frederikkoopman/Micro-Movinghead-Stepper/wiki/images/BodyAssembled.jpg

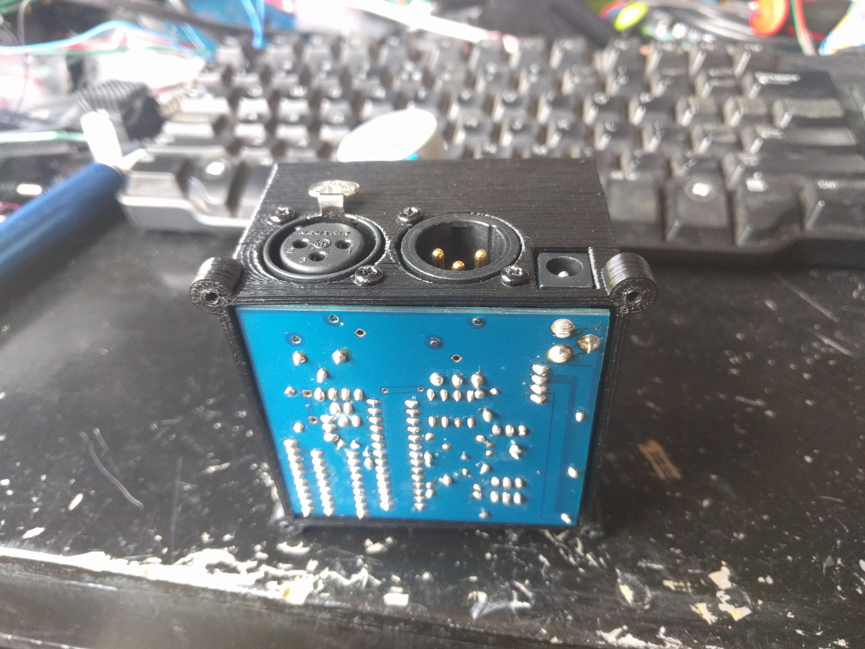
wiki/images/BodyAssembled.jpg
