frederikkoopman/Micro-Movinghead-Stepper/wiki/images/YokeMS.jpg

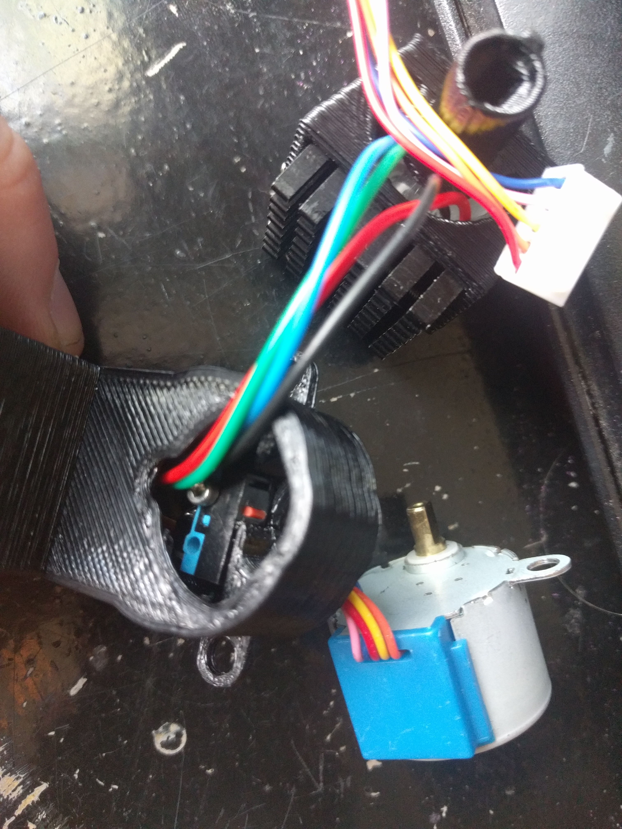
wiki/images/YokeMS.jpg
