frederikkoopman/Micro-Movinghead-Stepper/README.md

# Micro-Movinghead-Stepper
Micro Movinghead project stepper version
