frederikkoopman/Micro-Movinghead-Stepper/PCB/inputboard/readme.md

All Eagle files are here if your only interested in building not designing the zip file has all the files you need to order a PCB at your favorite PCB maker
