frederikkoopman/Micro-Movinghead-Stepper/wiki/images/Body.jpg

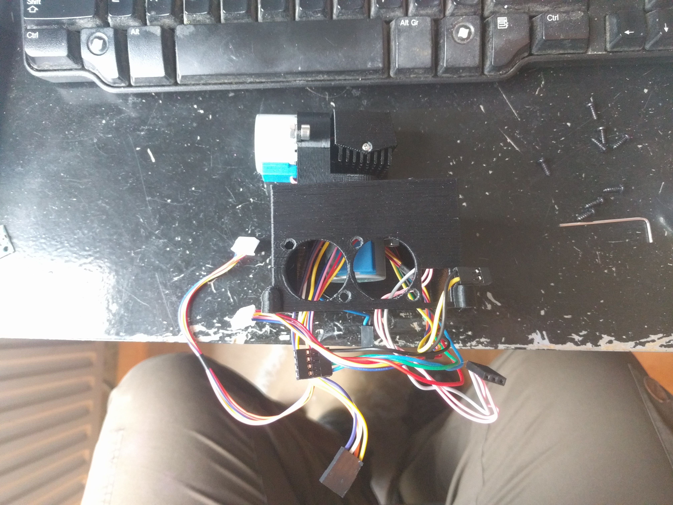
wiki/images/Body.jpg
