frederikkoopman/Micro-Movinghead-Stepper/wiki/images/Connections.jpg

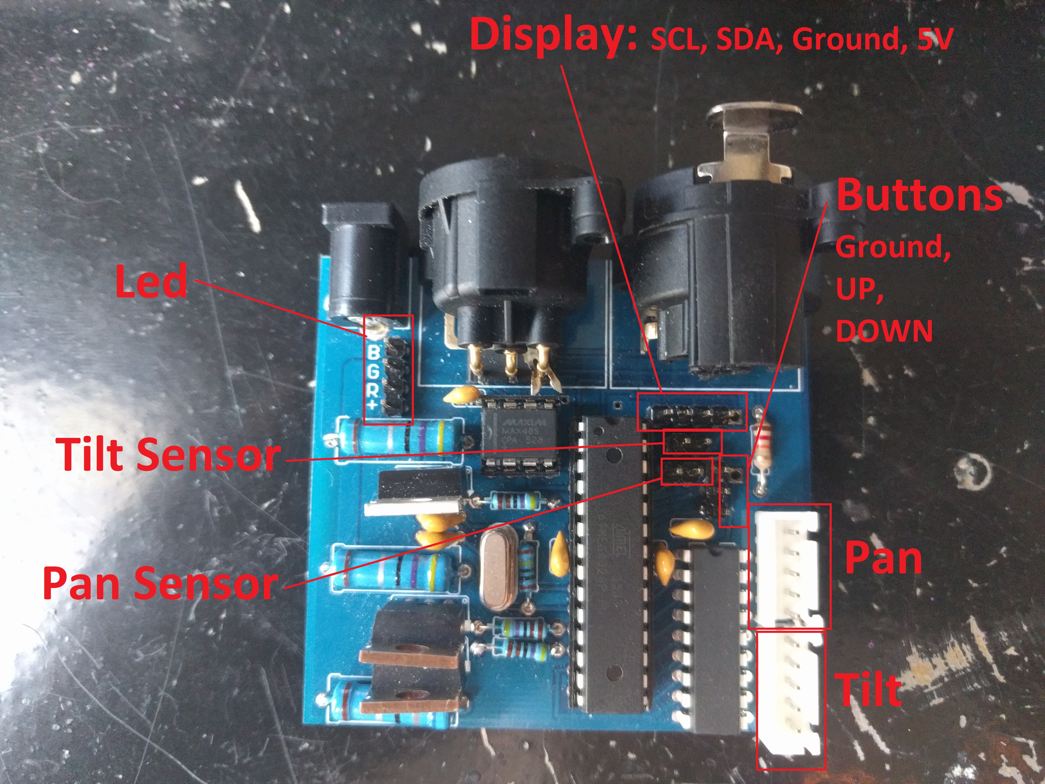
wiki/images/Connections.jpg
