frederikkoopman/Micro-Movinghead-Stepper/wiki/images/head.jpg

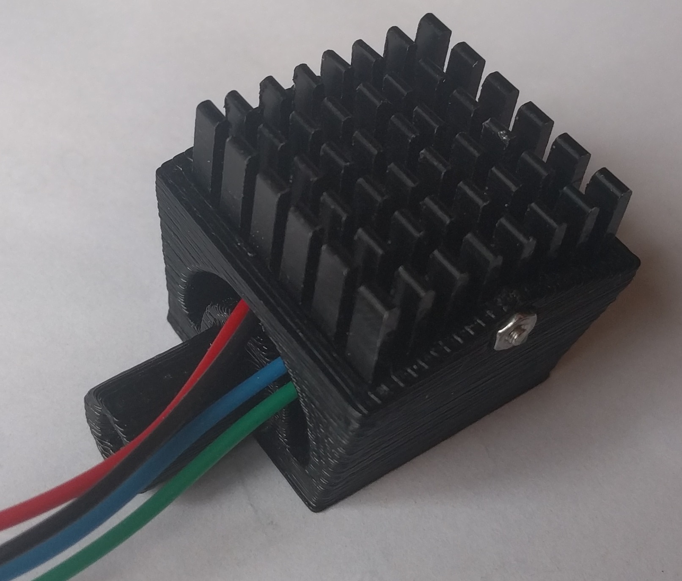
wiki/images/head.jpg
