frederikkoopman/Micro-Movinghead-Stepper/wiki/images/LED.jpg

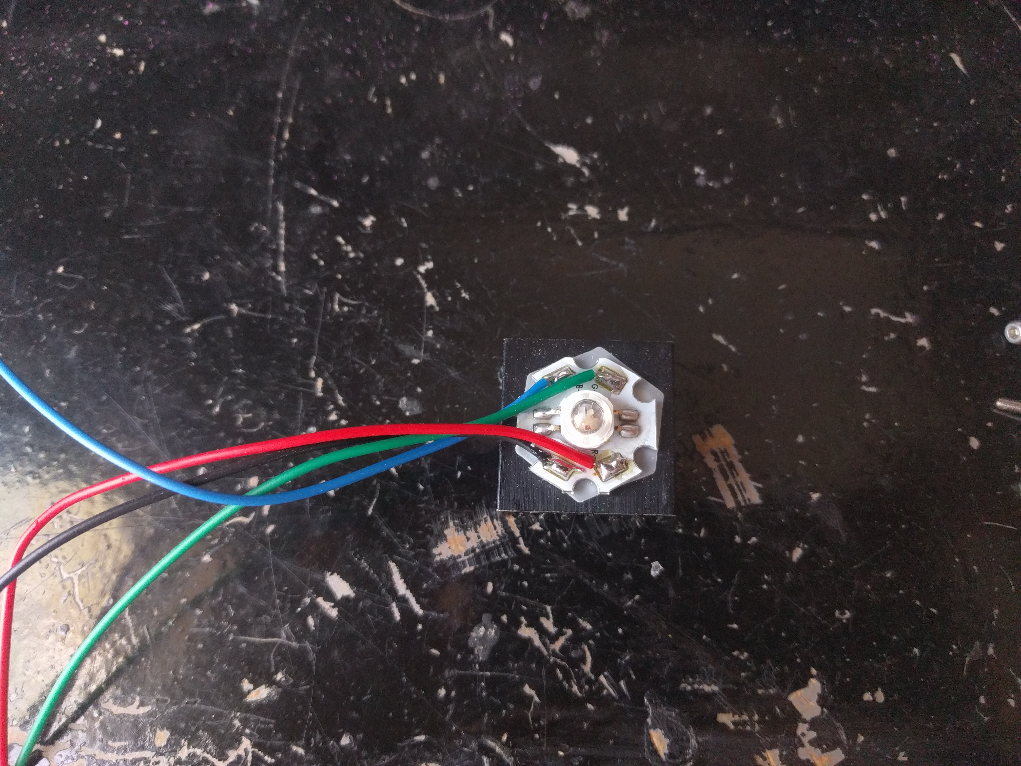
wiki/images/LED.jpg
