frederikkoopman/Micro-Movinghead-Stepper/wiki/images/Mainbody.jpg

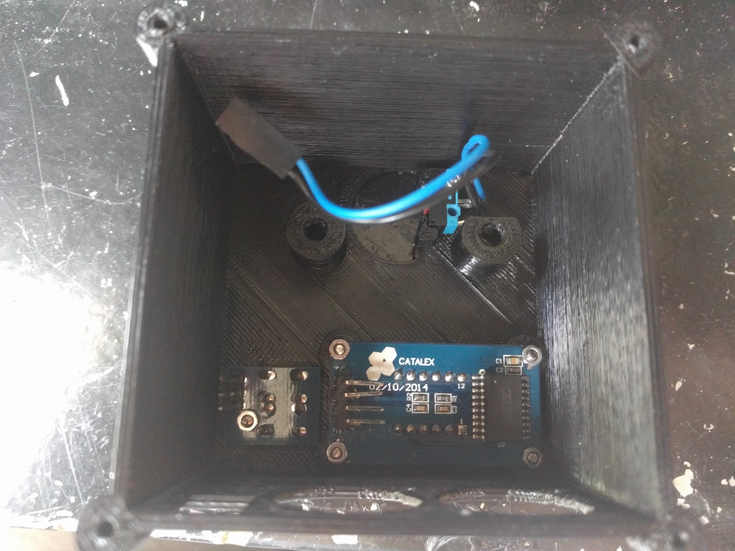
wiki/images/Mainbody.jpg
