frederikkoopman/Micro-Movinghead-Stepper/wiki/images/MainbodyConnections.jpg

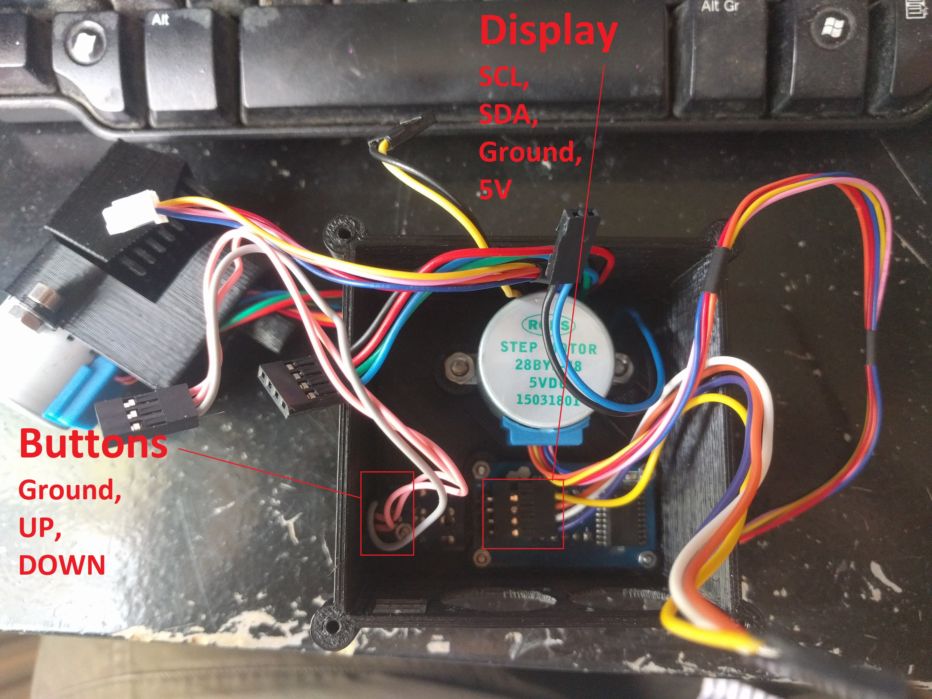
wiki/images/MainbodyConnections.jpg
