frederikkoopman/Micro-Movinghead-Stepper/wiki/images/MH.jpg

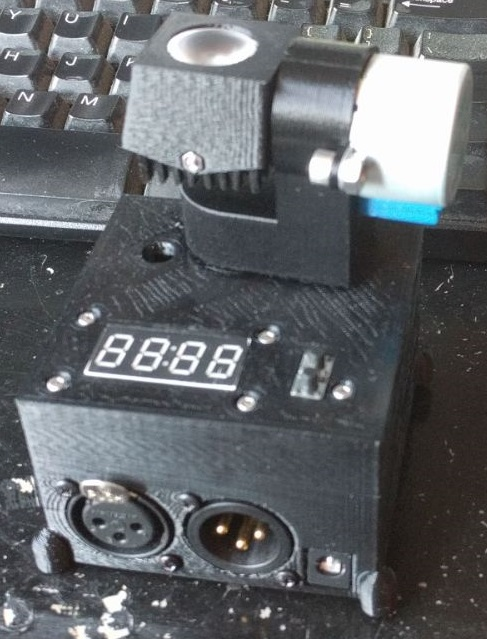
wiki/images/MH.jpg
