frederikkoopman/Micro-Movinghead-Stepper/wiki/images/MHTruss.jpg

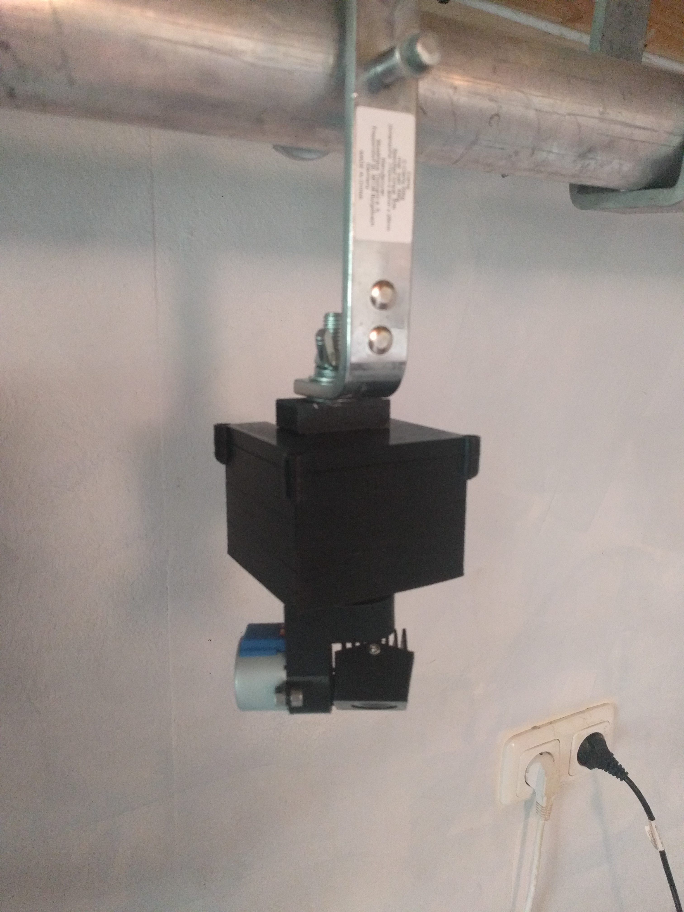
wiki/images/MHTruss.jpg
