frederikkoopman/Micro-Movinghead-Stepper/wiki/images/MicroMH2.jpg

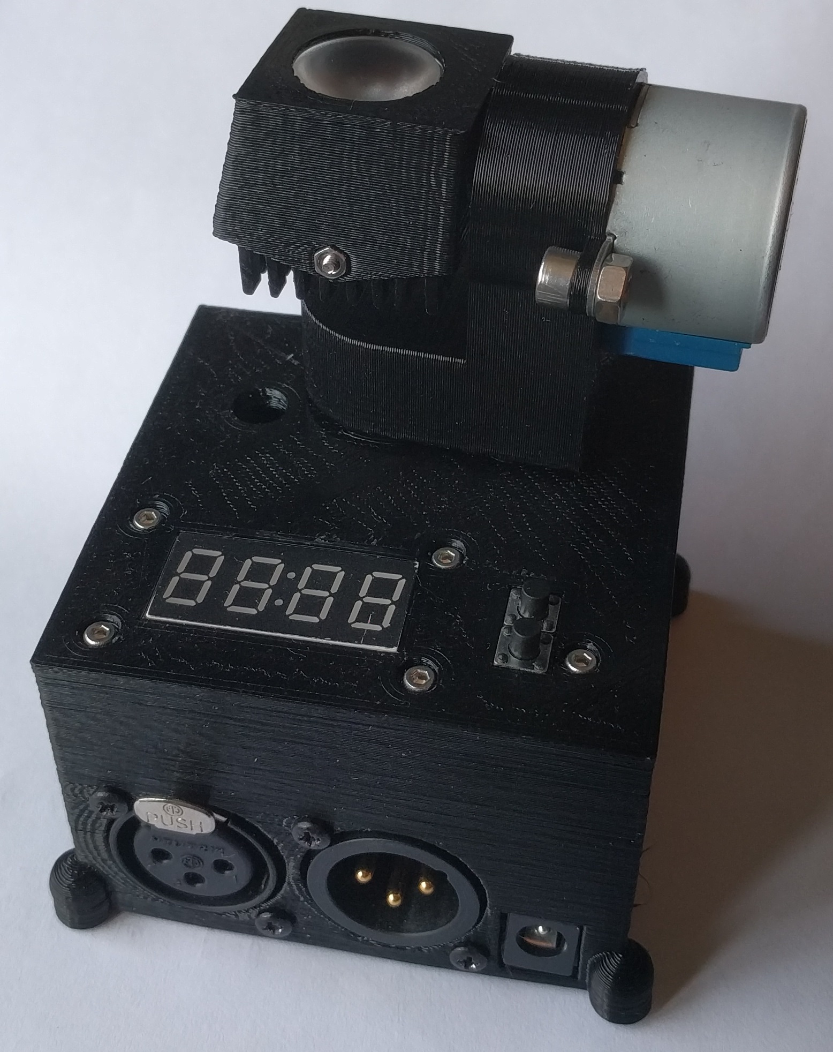
wiki/images/MicroMH2.jpg
