frederikkoopman/Micro-Movinghead-Stepper/wiki/images/MicroMH.jpg

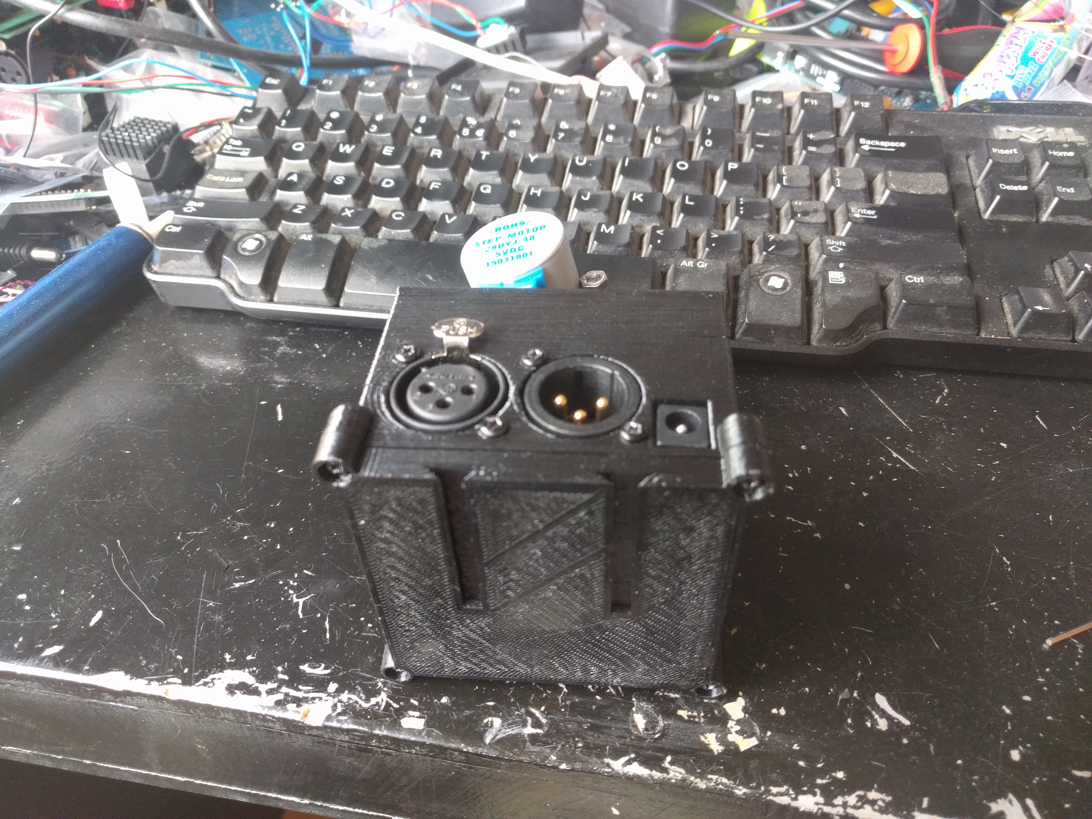
wiki/images/MicroMH.jpg
