frederikkoopman/Micro-Movinghead-Stepper/wiki/images/PCBs.jpg

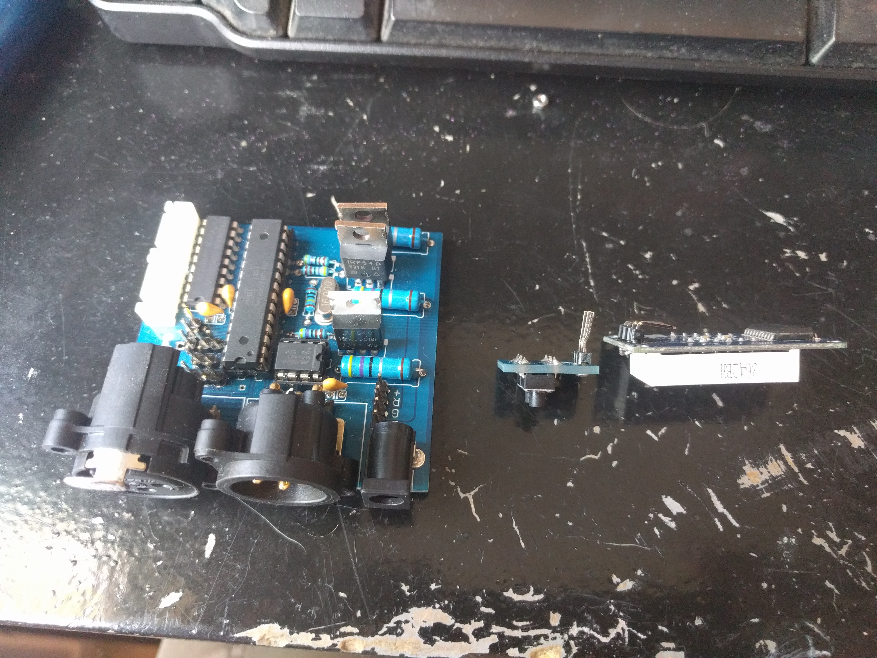
wiki/images/PCBs.jpg
