frederikkoopman/Micro-Movinghead-Stepper/wiki/images/support.png

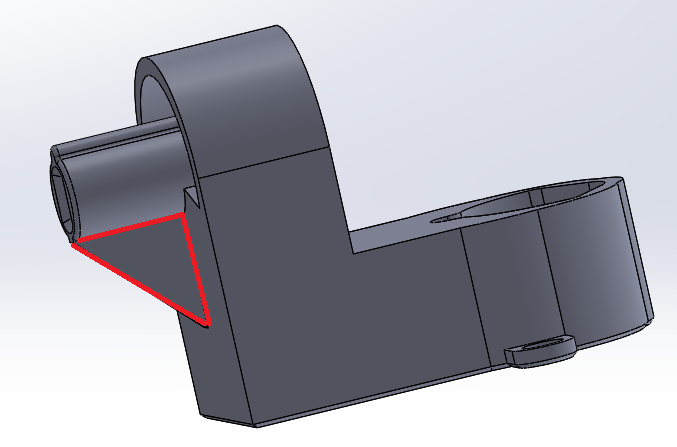
wiki/images/support.png
