frederikkoopman/Micro-Movinghead-Stepper/wiki/images/Wires.jpg

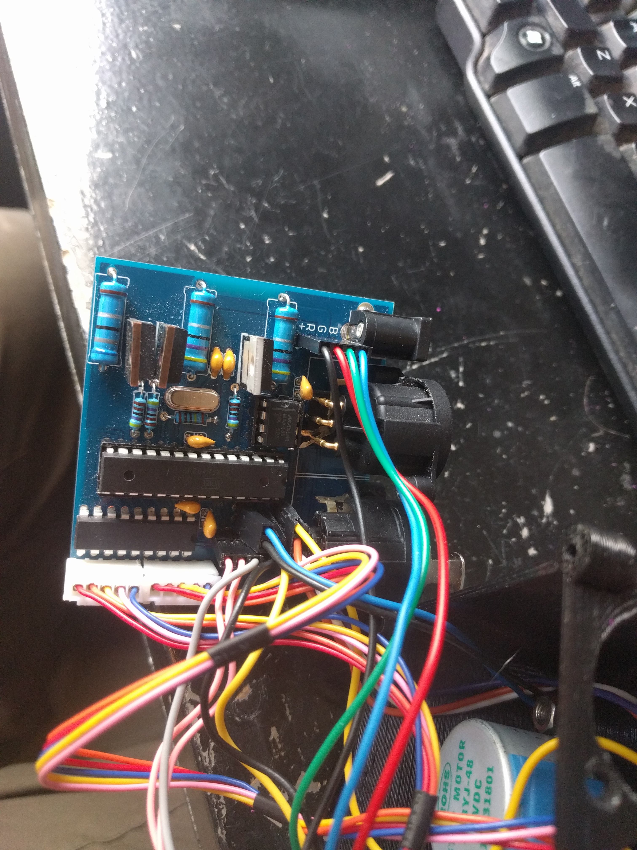
wiki/images/Wires.jpg
