frederikkoopman/Micro-Movinghead-Stepper/wiki/images/Yoke.jpg

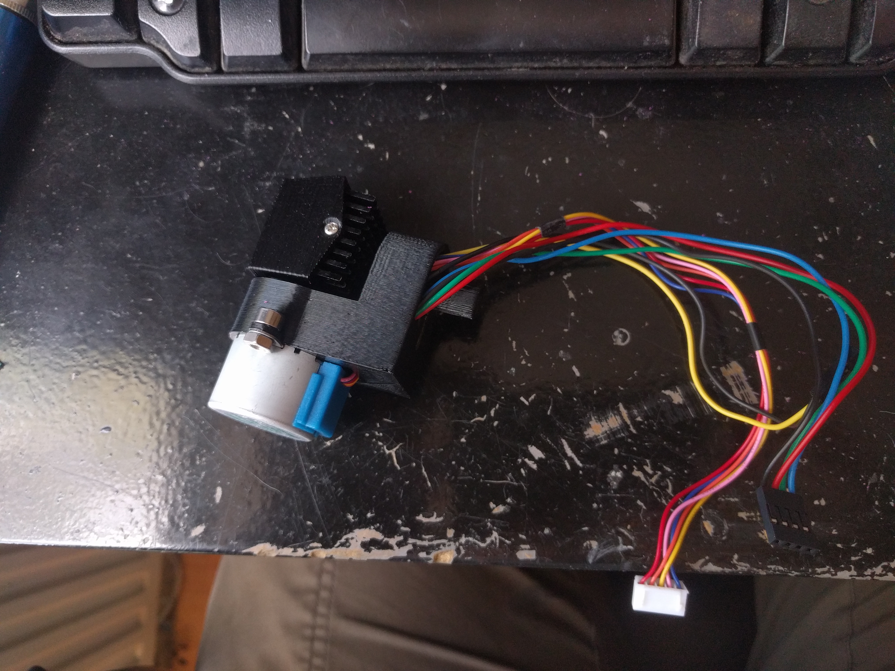
wiki/images/Yoke.jpg
