frederikkoopman/Micro-Movinghead-Stepper/wiki/images/yoke.png

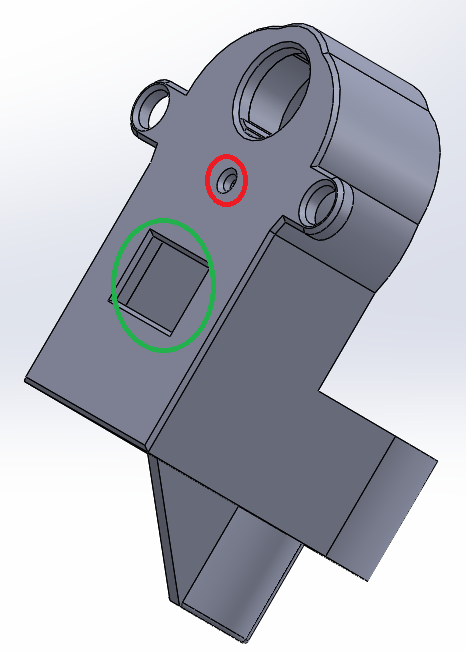
wiki/images/yoke.png
