frederikkoopman/Micro-Movinghead-Stepper/wiki/images/YokeWires.jpg

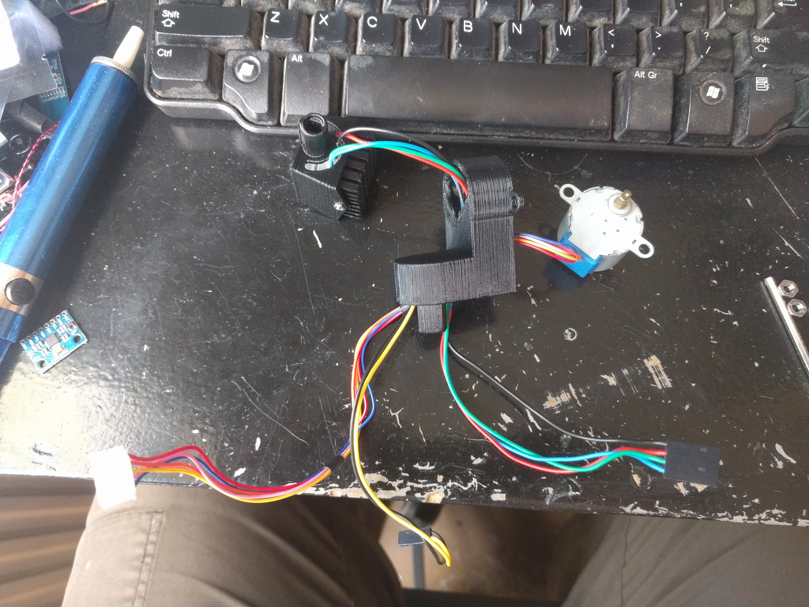
wiki/images/YokeWires.jpg
