frederikkoopman/Micro-Movinghead-Stepper/3D Models/SW files/Assem3.SLDASM

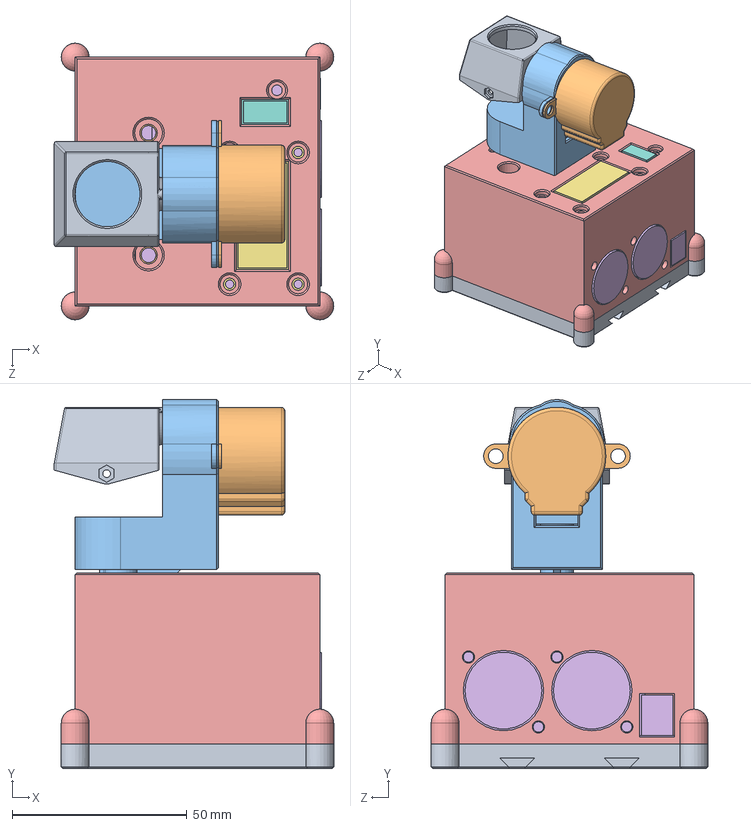
[picture p19: CAD file, 2017-03-17]
3D Models/SW files/Assem3.SLDASM
80.0 x 105.6 x 79.2 mm
Head2
Step Motor 28BYJ-48 x 2
Yoke3
sensor x 2
Mainbody
pcb
display
buttons
Cover
