frederikkoopman/Micro-Movinghead-Stepper/3D Models/STL files/Mainbody.STL

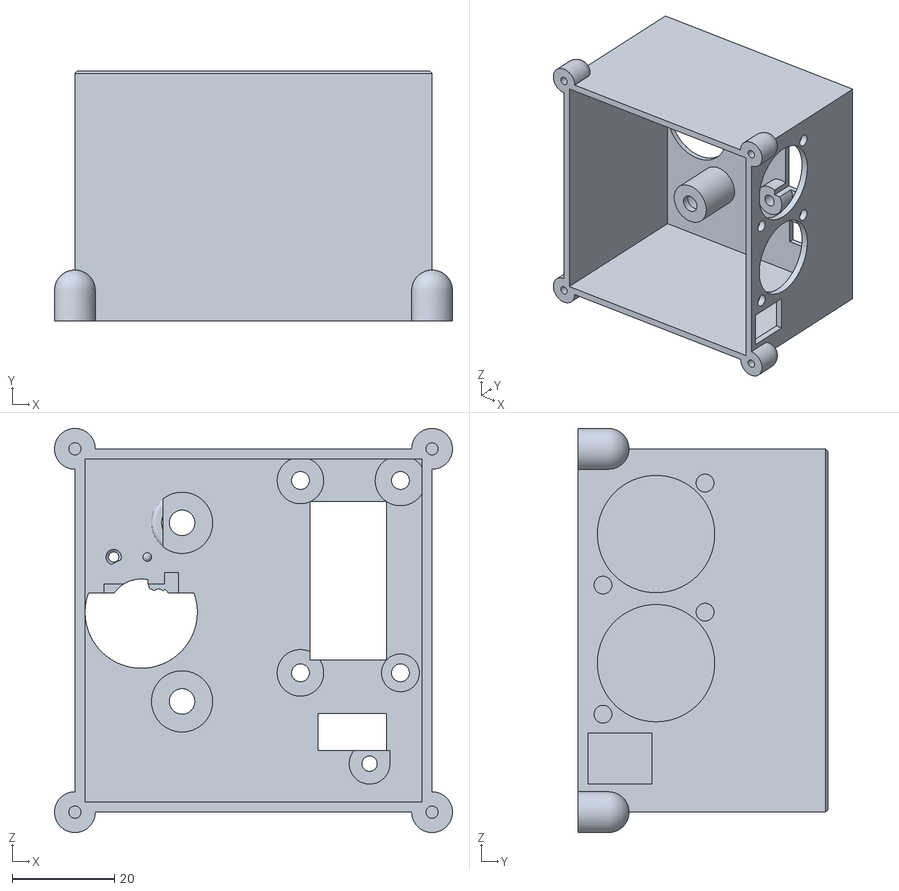
[picture p20: CAD file, 2017-03-17]
3D Models/STL files/Mainbody.STL
78.0 x 49.0 x 79.2
