frederikkoopman/Micro-Movinghead-Stepper/3D Models/STL files/slideon_fastner.STL

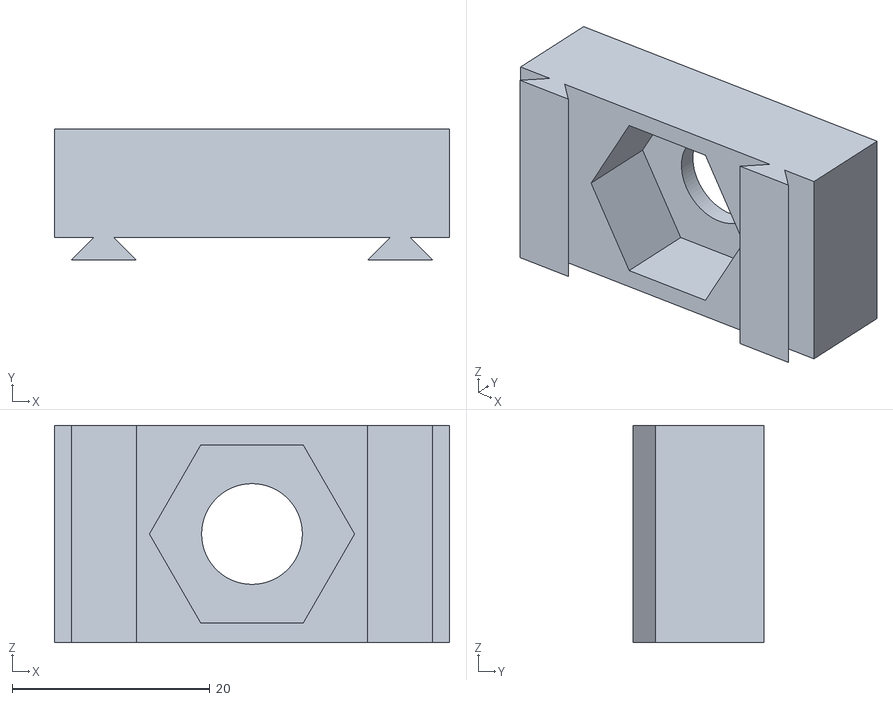
[picture p21: CAD file, 2017-03-17]
3D Models/STL files/slideon_fastner.STL
40.0 x 13.3 x 22.0
