frederikkoopman/Micro-Movinghead-Stepper/3D Models/STL files/Head2.STL

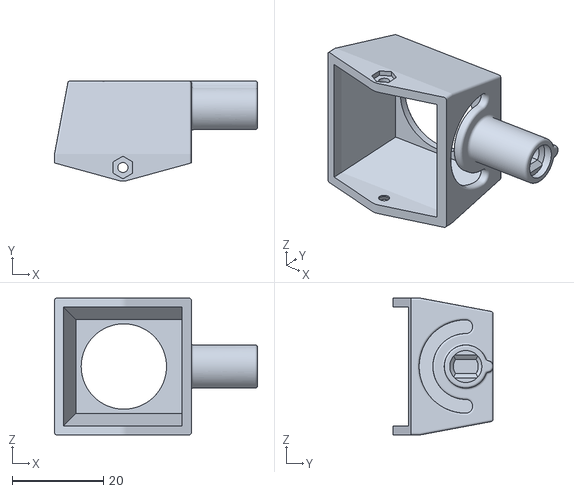
[picture p22: CAD file, 2017-03-17]
3D Models/STL files/Head2.STL
44.5 x 22.0 x 30.0
