frederikkoopman/Micro-Movinghead-Stepper/3D Models/SW files/Cover.sldprt

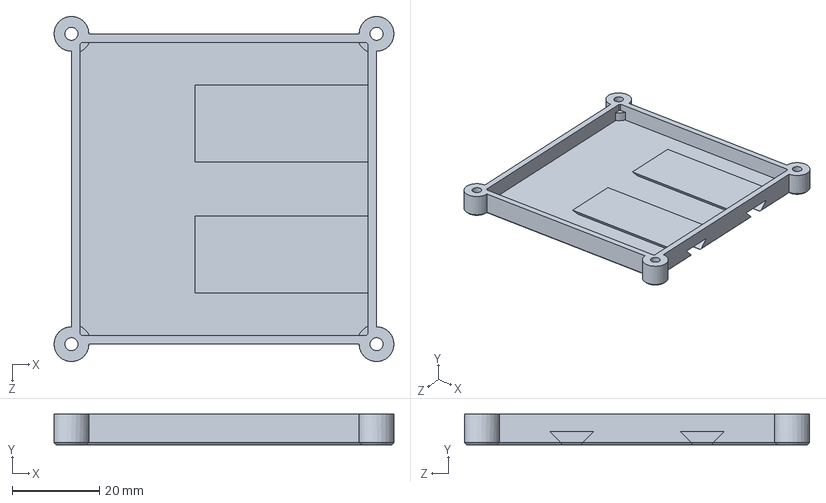
[picture p23: CAD file, 2017-03-17]
3D Models/SW files/Cover.sldprt
78.0 x 7.00 x 79.2 mm
