frederikkoopman/Micro-Movinghead-Stepper/3D Models/STL files/Yoke3.STL

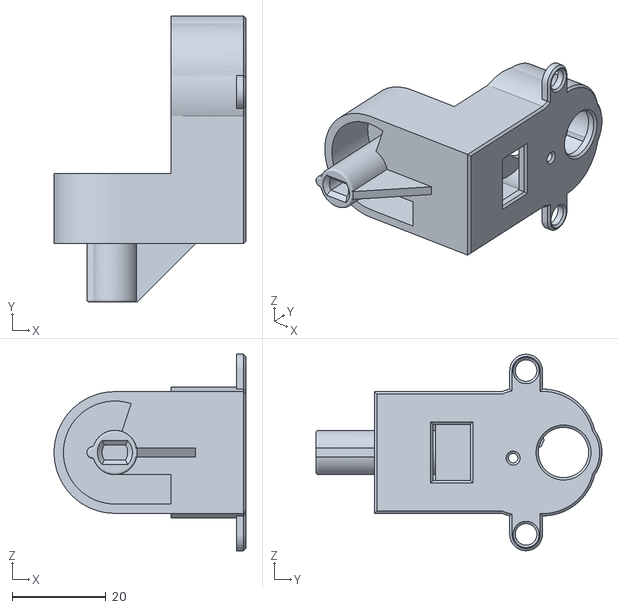
[picture p24: CAD file, 2017-03-17]
3D Models/STL files/Yoke3.STL
41.0 x 61.1 x 42.0
