frederikkoopman/Micro-Movinghead-Stepper/(list of files, cad)

Other CAD files:
3D Models/SW files/Mainbody.sldprt
3D Models/SW files/slideon_fastner.SLDPRT
3D Models/STL files/Cover.STL
3D Models/SW files/Yoke3.sldprt
3D Models/SW files/Head2.SLDPRT
