frederikkoopman/Micro-Movinghead-Stepper/PCB/inputboard/mh_stepper_con.brd

## EAGLE design PCB/inputboard/mh_stepper_con.brd (2017-03-17)

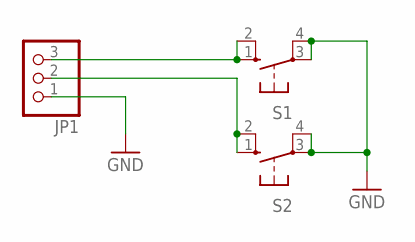
[picture p25: schematic mh_stepper_con.sch]

Parts:
JP1: PINHD-1X3; 1X03
S1, S2: 10-XX; B3F-10XX

Connections:
GND: JP1.1, S1.3, S1.4 (P1), S2.3, S2.4 (P1)
unnamed: JP1.3, S1.1 (S), S1.2 (S1)
unnamed: JP1.2, S2.1 (S), S2.2 (S1)

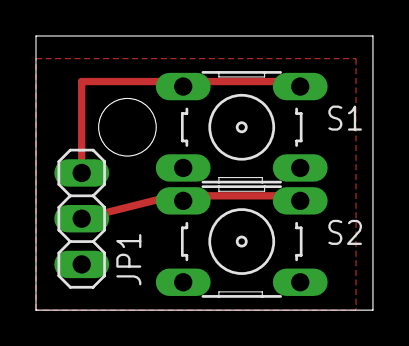
[picture p26: board mh_stepper_con.brd from above]

Board: 2 copper layers, 18.7 x 15.2 mm, 3 parts (0 on the bottom side), 3 nets.
