frederikkoopman/Micro-Movinghead-Stepper/PCB/mainboard/mh.brd

## EAGLE design PCB/mainboard/mh.brd (2017-03-17)

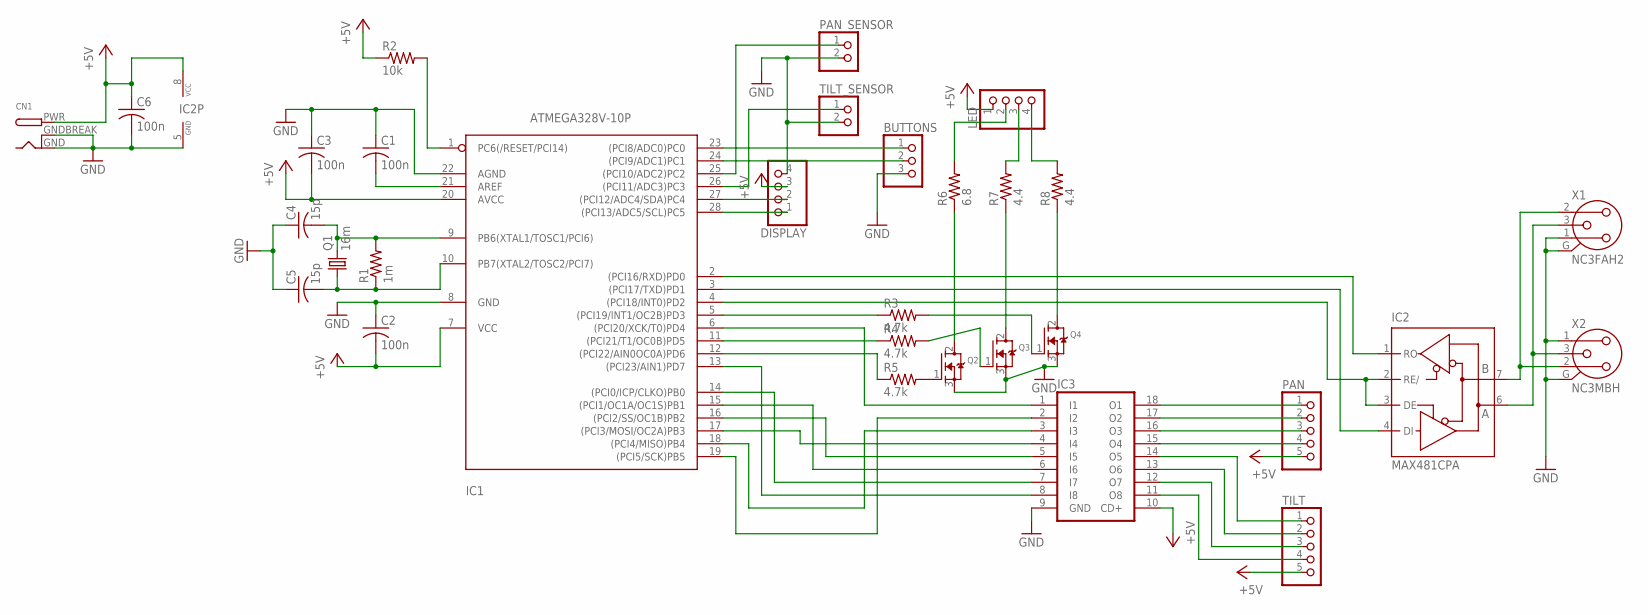
[picture p27: schematic mh.sch]

Parts:
BUTTONS: PINHD-1X3; 1X03
C1, C2, C3, C6: 100n; C025-024X044
C4, C5: 15p; C050-024X044
CN1: DCBARRELPTH; DCJACK_2MM_PTH
DISPLAY: PINHD-1X4; 1X04
IC1: ATMEGA328V-10P; DIL28-3
IC2: MAX481CPA; DIL08
IC3: ULN2803A; DIL18
LED: PINHD-1X4; 1X04
PAN: PINHD-1X5; 1X05
PAN_SENSOR: PINHD-1X2; 1X02
Q1: 16m; HC49/S
Q2, Q3, Q4: MOSFET-NGDS_TO220V; TO220V
R1: 1m; 0207/10
R2: 10k; 0207/10
R3, R4, R5: 4.7k; 0207/10
R6: 6.8; 0617/17
R7, R8: 4.4; 0617/17
TILT: PINHD-1X5; 1X05
TILT_SENSOR: PINHD-1X2; 1X02
X1: NC3FAH2
X2: NC3MBH

Connections:
+5V: C2.2, C3.2, C6.1, CN1.PWR, DISPLAY.3, IC1.7 (VCC), IC1.20 (AVCC), IC2.8 (VCC), IC3.10 (CD+), LED.1, PAN.5, R2.1, TILT.5
GND: BUTTONS.3, C1.1, C2.1, C3.1, C4.1, C5.1, C6.2, CN1.GND, CN1.GNDBREAK, DISPLAY.4, IC1.8 (GND), IC1.22 (AGND), IC2.5 (GND), IC3.9 (GND), PAN_SENSOR.2, Q2.3 (S), Q3.3 (S), Q4.3 (S), TILT_SENSOR.2, X1.1 (2), X1.G, X2.1, X2.G
unnamed: IC1.14 ((PCI0/ICP/CLKO)PB0), IC3.7 (I7)
unnamed: C5.2, IC1.10 (PB7(XTAL2/TOSC2/PCI7)), Q1.1, R1.1
unnamed: C1.2, IC1.21 (AREF)
unnamed: IC1.5 ((PCI19/INT1/OC2B)PD3), R3.1
unnamed: IC1.1 (PC6(/RESET/PCI14)), R2.2
unnamed: IC1.11 ((PCI21/T1/OC0B)PD5), R4.1
unnamed: IC1.12 ((PCI22/AIN0OC0A)PD6), R5.1
unnamed: Q2.1 (G), R5.2
unnamed: Q3.1 (G), R4.2
unnamed: Q4.1 (G), R3.2
unnamed: Q2.2 (D), R6.1
unnamed: Q3.2 (D), R7.1
unnamed: LED.4, R8.2
unnamed: LED.3, R7.2
unnamed: LED.2, R6.2
unnamed: IC1.19 ((PCI5/SCK)PB5), IC3.2 (I2)
unnamed: IC1.18 ((PCI4/MISO)PB4), IC3.3 (I3)
unnamed: IC1.17 ((PCI3/MOSI/OC2A)PB3), IC3.4 (I4)
unnamed: IC1.16 ((PCI2/SS/OC1B)PB2), IC3.5 (I5)
unnamed: IC1.15 ((PCI1/OC1A/OC1S)PB1), IC3.6 (I6)
unnamed: IC1.6 ((PCI20/XCK/T0)PD4), IC3.1 (I1)
unnamed: IC1.13 ((PCI23/AIN1)PD7), IC3.8 (I8)
unnamed: IC3.18 (O1), PAN.1
unnamed: IC3.17 (O2), PAN.2
unnamed: IC3.16 (O3), PAN.3
unnamed: IC3.15 (O4), PAN.4
unnamed: IC3.14 (O5), TILT.1
unnamed: IC3.13 (O6), TILT.2
unnamed: IC1.4 ((PCI18/INT0)PD2), IC2.2 (RE/), IC2.3 (DE)
unnamed: IC3.12 (O7), TILT.3
unnamed: IC1.3 ((PCI17/TXD)PD1), IC2.4 (DI)
unnamed: IC3.11 (O8), TILT.4
unnamed: DISPLAY.1, IC1.28 ((PCI13/ADC5/SCL)PC5)
unnamed: DISPLAY.2, IC1.27 ((PCI12/ADC4/SDA)PC4)
unnamed: IC1.2 ((PCI16/RXD)PD0), IC2.1 (RO)
unnamed: IC1.25 ((PCI10/ADC2)PC2), PAN_SENSOR.1
unnamed: IC1.26 ((PCI11/ADC3)PC3), TILT_SENSOR.1
unnamed: C4.2, IC1.9 (PB6(XTAL1/TOSC1/PCI6)), Q1.2, R1.2
unnamed: BUTTONS.1, IC1.23 ((PCI8/ADC0)PC0)
unnamed: IC2.7 (B), X1.2 (1), X2.2
unnamed: BUTTONS.2, IC1.24 ((PCI9/ADC1)PC1)
unnamed: IC2.6 (A), X1.3, X2.3
unnamed: Q4.2 (D), R8.1

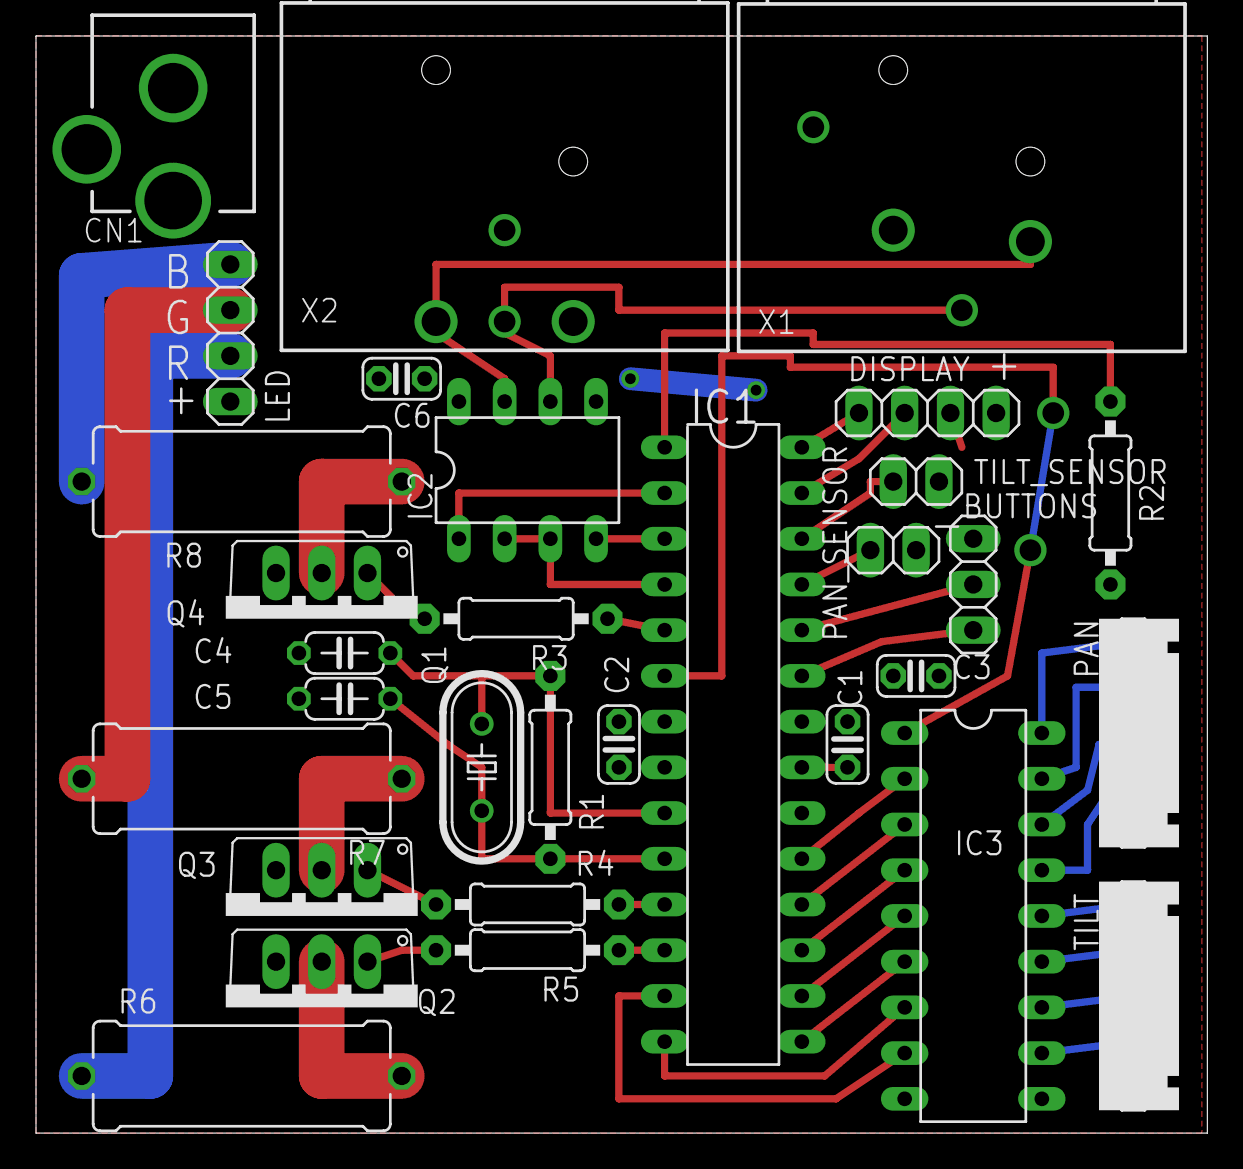
[picture p28: board mh.brd from above]

Board: 2 copper layers, 65.1 x 61.0 mm, 31 parts (0 on the bottom side), 45 nets.
